xoimons/lora_Heltec/REV_Final.jpg

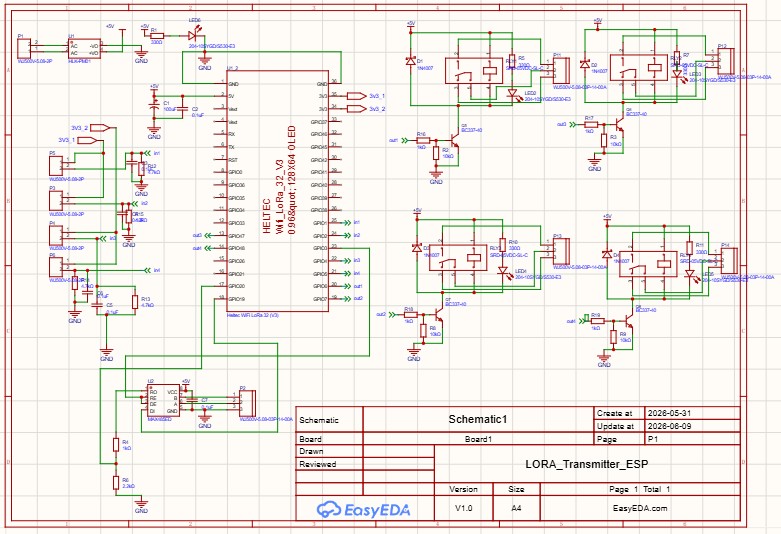
REV_Final.jpg
