xoimons/lora_Heltec/Captura de pantalla 2026-06-24 195054.png

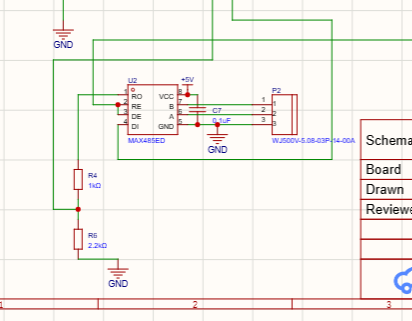
Captura de pantalla 2026-06-24 195054.png
