xoimons/lora_Heltec/disseny1.bmp

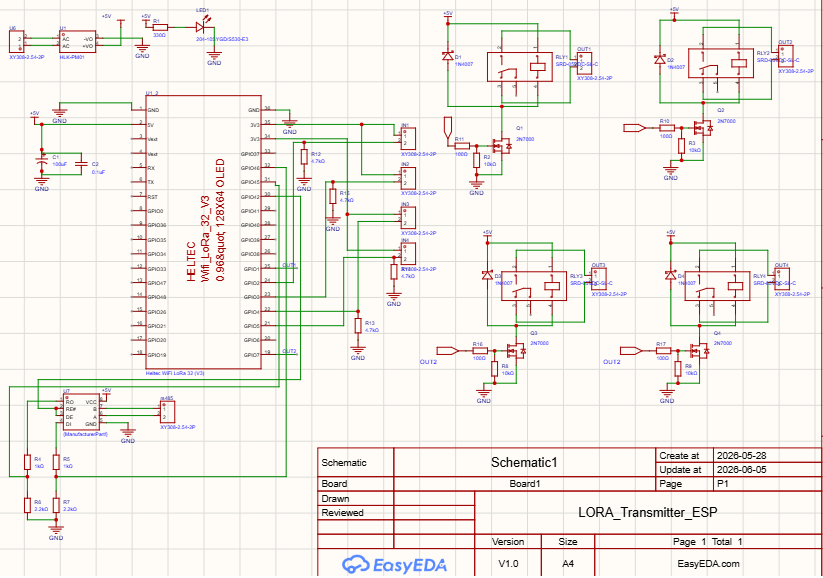
disseny1.bmp
