xoimons/lora_Heltec/projecte_brainstoming_20_emisors/pressupost.xlsx

Sheet: Pressupost Mestre
PRESSUPOST MESTRE
Resum consolidat de totes les pestanyes
Partida | Import | % sobre subtotal
Material | 6592.00 € | 46.3%
Mà d'obra, despeses i desplaçaments - Sergi | 0.00 € | 0.0%
Mà d'obra, despeses i desplaçaments - Jordi | 7647.00 € | 53.7%
SUBTOTAL | 14239.00 €
IVA | 2990.19 €
Tipus d'IVA | 21.0%
TOTAL PRESSUPOST | 17229.19 €

Sheet: Material
MATERIAL
TOTAL MATERIAL | 6592.00 €
Material comprat | 310.00 €
Material per dipòsit | 6282.00 €
Registra cada compra a les files de sota. L'import es calcula automàticament.
Concepte | Quantitat | U. | Preu unitari | Import
Antena recepcio | 1.00 |  | 60.00 € | 60.00 €
RAKWireless RAK7268V2 (WisGate Developer D-sub) | 1.00 |  | 200.00 € | 200.00 €
cablejat i soports | 1.00 |  | 50.00 € | 50.00 €

Sheet: Material per diposit
MATERIAL PER DIPÒSIT
Cost per dipòsit | 349.00 €
Nombre de dipòsits | 18
TOTAL MATERIAL PER DIPÒSIT | 6282.00 €
Registra cada compra a les files de sota. L'import es calcula automàticament.
Concepte | Quantitat | U. | Preu unitari | Import
Pcb | 1.00 |  | 120.00 € | 120.00 €
Caixa Pcb | 1.00 |  | 15.00 € | 15.00 €
cablejat | 1.00 |  | 20.00 € | 20.00 €
placa solar 12v 10w | 1.00 |  | 30.00 € | 30.00 €
regulador pwm | 1.00 |  | 30.00 € | 30.00 €
bateria | 1.00 |  | 45.00 € | 45.00 €
antena | 1.00 |  | 55.00 € | 55.00 €
sensor pressio | 1.00 |  | 30.00 € | 30.00 €
tub encapsulat sensor | 1.00 |  | 4.00 € | 4.00 €

Sheet: Sergi
SERGI
Tarifa €/hora | 30.00 €
Preu €/km | 0.30 €
Total mà d'obra | 0.00 €
Total despeses | 0.00 €
Total desplaçaments | 0.00 €
TOTAL SERGI | 0.00 €
MÀ D'OBRA |  |  | DESPESES |  | DESPLAÇAMENTS
Tasca | Hores | Import | Concepte | Import | Destinació / motiu | Km | Hores | Import

Sheet: Jordi
JORDI
Tarifa €/hora | 30.00 €
Preu €/km | 0.30 €
Total mà d'obra | 6900.00 €
Total despeses | 0.00 €
Total desplaçaments | 747.00 €
TOTAL JORDI | 7647.00 €
MÀ D'OBRA |  |  | DESPESES |  | DESPLAÇAMENTS
Tasca | Hores | Import | Concepte | Import | Destinació / motiu | Km | Hores | Import
Disseny PCB | 30.00 | 900.00 € |  |  | Ossera, Test inicial | 230.00 | 6.00 | 249.00 €
Programacio microprocessadors estacions | 12.00 | 360.00 € |  |  | Ossera field review | 230.00 | 6.00 | 249.00 €
Programacio receptor lora | 12.00 | 360.00 € |  |  | Ossera posada a punt final | 230.00 | 6.00 | 249.00 €
Programacio distribucio i assignament en DB | 20.00 | 600.00 €
Test de recepcio, assignacio i distribucio DB | 8.00 | 240.00 €
Programacio pagina web | 140.00 | 4200.00 €
Test pagina web | 8.00 | 240.00 €
