xoimons/lora_Heltec/projecte_brainstoming_20_emisors/Pressupost_projecte_LoRa_20nodes.xlsx

Sheet: Node emissor
Component | Preu unitari (EUR) | Quantitat | Subtotal (EUR)
ESP32-C3 (modul MINI-1) | 2.000 | 1 | 2.000
Modul LoRa SX1262 + PA (ex. E22-900M30S) | 10.000 | 1 | 10.000
Passius i proteccio entrades digitals (x4) | 1.500 | 1 | 1.500
Divisor i proteccio entrada analogica 0-10V | 1.000 | 1 | 1.000
Regulador tensio (LDO/buck) + proteccio bateria | 1.500 | 1 | 1.500
PCB fabricacio (tirada petita) | 2.000 | 1 | 2.000
Portapiles / connector bateria | 0.750 | 1 | 0.750
Antena (whip/rod, baix guany, SMA) | 5.000 | 1 | 5.000
Caixa estanca IP65 + premsaestopes | 8.000 | 1 | 8.000
Piles (ex. Li-ion 18650 protegides) | 5.000 | 2 | 10.000
TOTAL PER NODE |  |  | 41.750

Sheet: Receptor (comu)
Component | Preu unitari (EUR) | Quantitat | Subtotal (EUR)
HAT concentrador LoRa multicanal (ex. RAK2287) | 100.000 | 1 | 100.000
Raspberry Pi 4/5 (4GB) | 60.000 | 1 | 60.000
Targeta microSD 32GB | 10.000 | 1 | 10.000
Font alimentacio RPi (5V/3A) | 9.000 | 1 | 9.000
Antena exterior de pal | 25.000 | 1 | 25.000
Cable coaxial baixa perdua + connectors | 25.000 | 1 | 25.000
Protector sobretensions (linia antena) | 20.000 | 1 | 20.000
Caixa estanca RPi + HAT | 15.000 | 1 | 15.000
TOTAL INFRAESTRUCTURA RECEPTOR |  |  | 264.000

Sheet: Resum
Nombre de nodes emissors | 20
Cost per node emissor (EUR) | 41.750
Cost total nodes emissors (EUR) | 835.000
Cost total infraestructura receptor (EUR) | 264.000
COST TOTAL PROJECTE (EUR) | 1099.000
Nota: preus orientatius, a validar amb pressupostos reals de proveidor (LCSC/Mouser/Digikey) segons volum final.
