xoimons/lora_Heltec/firmware_mqtt_failsafe/emissor/config.h

#ifndef CONFIG_H
#define CONFIG_H

// ============================================
// Configuracio Emissor
// Sistema LoRa punt a punt - Monitoratge boia
// ============================================

// --- Pins d'entrada ---
#define IN1_PIN  5
#define IN2_PIN  1
#define IN3_PIN  4
#define IN4_PIN  2

// --- RS485 (MAX485 no poblat a l'emissor, pero GPIO3 es forca LOW) ---
#define RS485_DE_RE_PIN  3

// --- Parametres LoRa ---
#define RF_FREQUENCY          868000000  // 868 MHz (Europa ISM)
#define TX_OUTPUT_POWER       14         // dBm
#define LORA_BANDWIDTH        0          // 0: 125 kHz
#define LORA_SPREADING_FACTOR 7          // SF7
#define LORA_CODINGRATE       1          // 4/5
#define LORA_PREAMBLE_LENGTH  8
#define LORA_FIX_LENGTH_PAYLOAD_ON false
#define LORA_IQ_INVERSION_ON  false
#define LORA_SYMBOL_TIMEOUT   0
#define BUFFER_SIZE           1          // 1 byte de payload

// --- Temporitzadors ---
#define TX_INTERVAL_MS       60000   // Enviar cada 60 segons (1 minut)
#define POLL_INTERVAL_MS     50      // Polling entrades cada 50 ms
#define DEBOUNCE_CONFIRM_MS  500   // 500ms per confirmar canvi d'estat (500 ms)

// --- Serial ---
#define SERIAL_BAUD 115200

#endif // CONFIG_H
