xoimons/lora_Heltec/(commit log)

2026-08-06 Initial commit: LoRa Heltec project with SVG dashboard
    - Firmware for LoRa emitter/receiver (ESP32 Heltec)
    - MQTT receptor with HiveMQ integration
    - Interactive SVG dashboard with synoptic industrial layout
    - Deye inverter Modbus integration docs
    - Project documentation and schematics
2026-08-06 Reorder dashboard cards: tank, pump, deye, inputs, lora
2026-08-06 Fix TLS: use root CA certificate instead of setInsecure()
    [test_mqtt_hivemq.ino]
2026-08-12 Add fail-safe firmware versions and remove Deye/RS485 from MQTT
    - New firmware_failsafe/: buoy wiring changed from NO to NC for fail-safe
    (disconnected = 0 = pump OFF). boiaBomba stays NO for dry-run protection.
    - New firmware_mqtt_failsafe/: same fail-safe logic + removed all Deye/RS485/
    Modbus code and SOC logic. MQTT publish interval changed to 30s.
    RSSI shown on OLED display instead of Deye values.
    - Dashboard updated: removed Deye card, 2-column grid layout.
    - Updated project documentation (decisions, estat, document complet).
    - Removed unused install_esp32_manual.bat.
    [config.h, emissor.ino, receptor.ino, receptor_mqtt.ino, test_mqtt_hivemq.ino]
2026-08-21 Rename input labels in dashboard and add MQTT failsafe emissor
    - Rename IN1 to "Nivell Dipòsit" and IN2 to "Mitja Càrrega" in Webvisu dashboard
    - Reduce debounce confirm time to 100ms in emissor config
    - Add emissor copy to firmware_mqtt_failsafe
    - Add centralitzacio_diposits folder
    [config.h, emissor.ino]
2026-09-01 Add Deye inverter to dashboard, fix receptor logic, and add ESP-to-MQTT firmware
    - Webvisu: add second tank (Ossera), Deye inverter card with battery SOC,
    subscribe to deye/# topics, rename OUT4 label
    - Receptor: fix OUT2/OUT3 logic (remove NC inversion), use insecure TLS,
    add periodic NTP retry, update WiFi to Solar_Ossera, increase pot max to 8h
    - Emissor: increase debounce to 500ms
    - Add ESP_to_mqtt firmware project
    - Add brainstorming docs for 20-node LoRa project
    [Pressupost_projecte_LoRa_20nodes.xlsx, pressupost.xlsx]
2026-09-03 Mou LEDs diposit clor al costat dret; reverteix logica diposits a 1=ple/0=buit directe
2026-09-03 Corregeix logica in1 (Ossera): compara numericament per evitar bug de string truthy
2026-09-03 Endureix handleMessage: try/catch complet i validacio de data per evitar que un error trenqui el flux MQTT
2026-09-03 Afegeix log de consola per a cada missatge MQTT rebut (diagnostic)
2026-09-03 Fix critic: updateTank(Ossera) usava ID incorrecte (water-body2 en comptes de water-body-2), causava excepcio i trencava el refresc
2026-09-03 Treu majuscules forcades (text-transform) de titols de rajoles i etiquetes LED
2026-09-03 Afegeix columna de 3 LEDs (verd/taronja/vermell) al diposit Ossera per representar max/mig-carrega/buit
2026-09-03 Canvia LED mig-carrega Ossera de taronja a verd
2026-09-03 LED minim Ossera: verd si ple, vermell si buit (sempre ences, no apagat)
2026-09-03 Treu el dibuix de la boia (float) dels dos diposits
2026-09-03 Iguala nivell ple Ossera amb Madern, afegeix LEDs max/min a Madern, revert estil text PLE/BUIT
2026-09-03 Enrasa linia maxim aigua amb led maxim; centra etiquetes Madern/Ossera sobre el diposit
2026-09-06 Ajusta nivell aigua dipòsit clor: ple alineat amb LED superior, buit amb LED inferior
2026-09-06 Fix LED vermell dipòsit clor: usa setLed amb color vermell explícit
2026-09-06 Fix LED vermell clor: aplica fill/stroke/filter directament sense setLed
2026-09-06 Fix LED vermell clor: animació glow-red separada, augmenta font 25%
    L'animació CSS glow (verda) sobreescrivia el fill vermell.
    Ara el LED inferior usa classe active-red amb glow vermell propi.
2026-09-06 Treu transition filter del led-circle que interferia amb animació glow-red
2026-09-06 Refet LED clor: tot inline setAttribute, sense classes CSS ni setLed
    LED inferior comença vermell per defecte al HTML.
    updateClorTank només fa setAttribute fill/stroke directament.
2026-09-06 LED clor: usa style.fill en lloc de setAttribute per màxima prioritat CSS
    Afegit console.log per debug.
2026-09-06 Fix LEDs inferiors Madern i Ossera: style.fill com clor, treu console.log
2026-09-06 Tots els LEDs diposits usen style.fill: Ossera max/mig/min i Madern max
2026-09-09 Fix LED inferior Madern: gris quan boia=1, vermell quan boia=0
2026-09-09 Bateria Deye: verd suau fix; LED inferior Ossera: gris quan ple, vermell quan buit
2026-09-09 Fix bateria Deye buida: treu animate buit que sobreescrivia y/height del JS
2026-09-09 LED inferior Ossera: vermell nomes si in1=1 (buit) i in2=0 (mig buit)
2026-09-09 Bateria Deye blau com dipòsits; LED inferior Clor Ossera gris/vermell igual que la resta
2026-09-09 Mostra potencia de sortida del Deye a la rajola del dashboard
